aramachandran7/amp_class_d_GaN/amp/amp.pdf

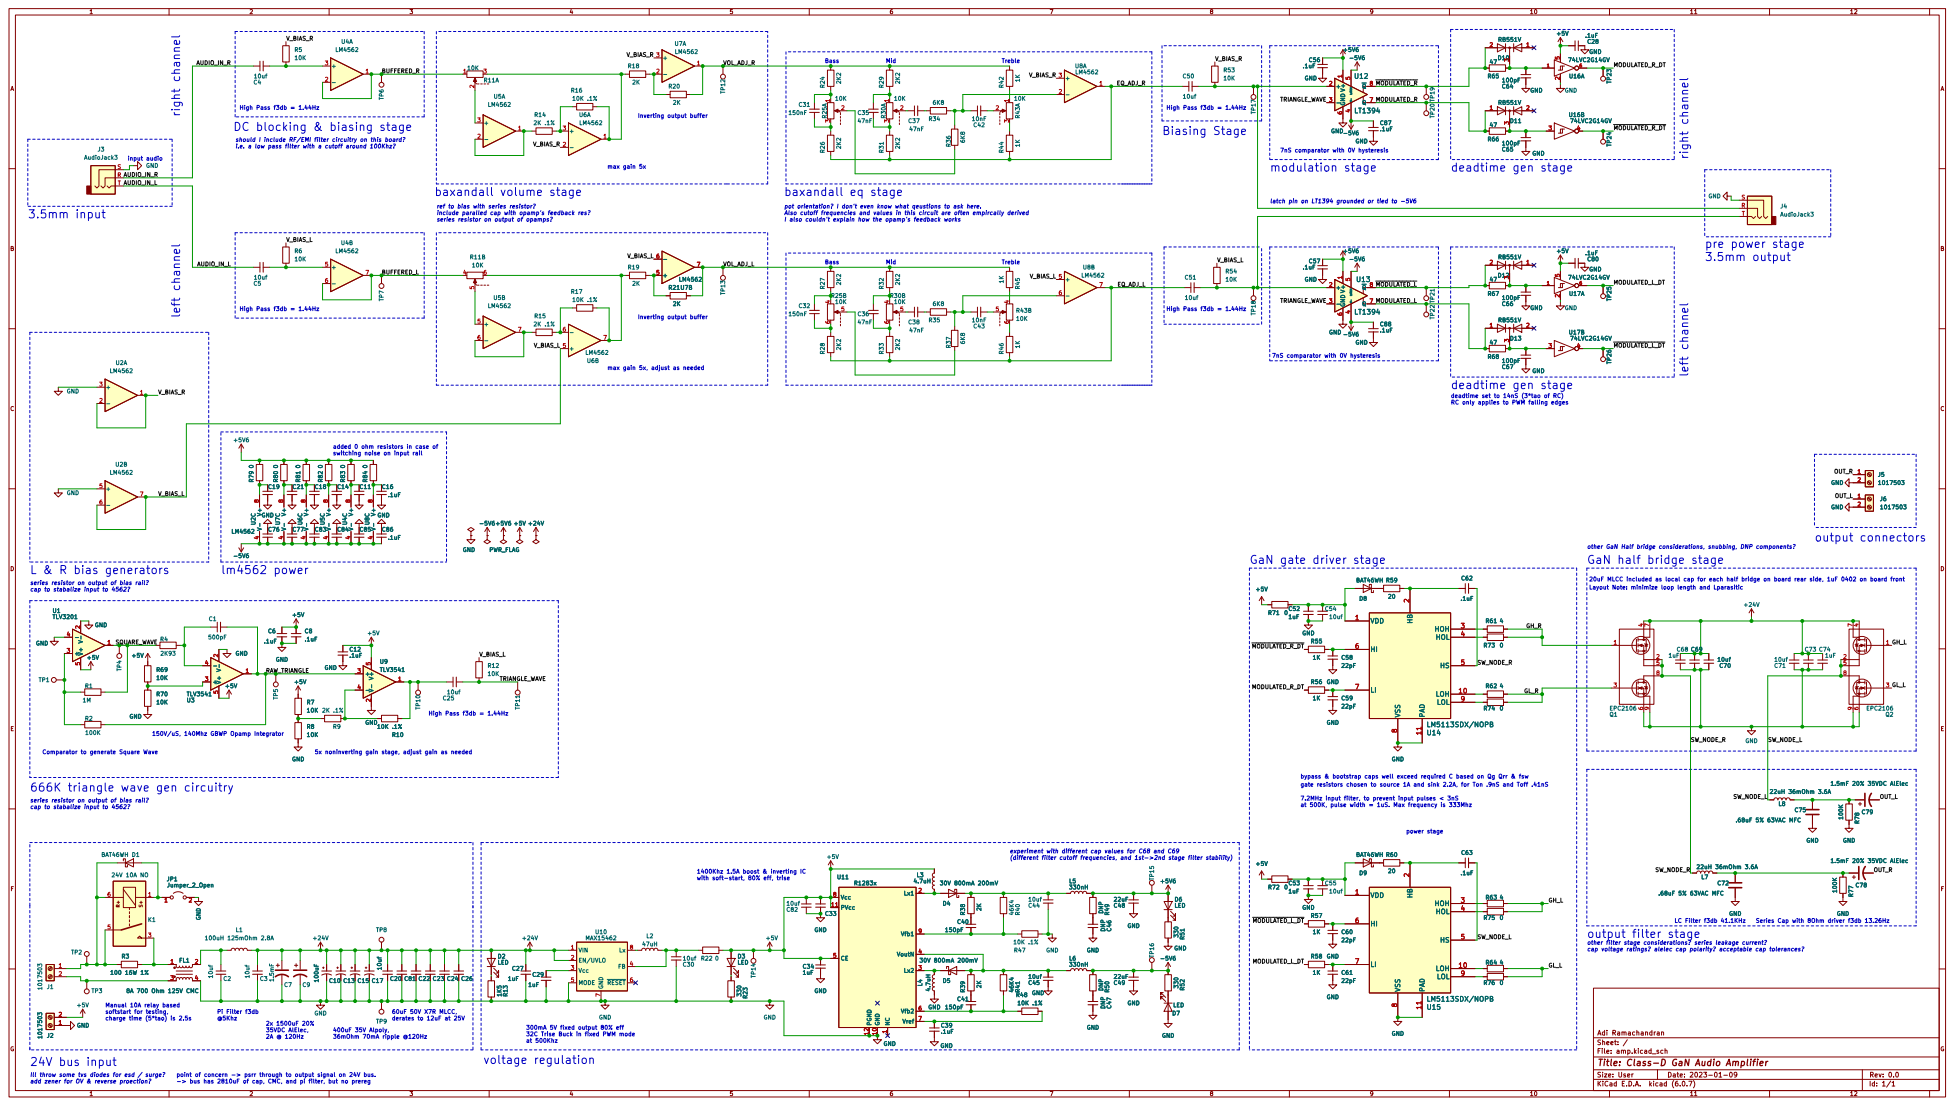
[picture p1: page 1]

DC blocking & biasing stage right channel

File: amp.kicad_sch Sheet: / Adi Ramachandran TP19 R60

should I include RF/EMI filter circuitry on this board?
i.e. a low pass filter with a cutoff around 100Khz?

ref to bias with series resistor?
include paralled cap with opamp's feedback res?
series resistor on output of opamps?

pot orientation? I don't even know what qeustions to ask here.
Also cutoff frequencies and values in this circuit are often empircally derived

latch pin on LT1394 grounded or tied to -5V6

I also couldn't explain how the opamp's feedback works added 0 ohm resistors in case of switching noise on input rail

max gain 5x, adjust as needed

deadtime set to 14nS (3*tao of RC)

other GaN Half bridge considerations, snubbing, DNP components?
GaN half bridge stage

GaN gate driver stage

20uF MLCC included as local cap for each half bridge on board rear side, 1uF 0402 on board front
Layout Note: minimize loop length and Lparasitic

series resistor on output of bias rail?
cap to stabalize input to 4562?

150V/uS, 140Mhz GBWP Opamp Integrator

power stage bypass & bootstrap caps well exceed required C based on Qg Qrr & fsw
gate resistors chosen to source 1A and sink 2.2A, for Ton .9nS and Toff .41nS

666K triangle wave gen circuitry

7.2MHz input filter, to prevent input pulses < 3nS
at 500K, pulse width = 1uS. Max frequency is 333Mhz

(different filter cutoff frequencies, and 1st->2nd stage filter stability)

1400Khz 1.5A boost & inverting IC with soft-start, 80% eff, trise

cap voltage ratings? alelec cap polarity? acceptable cap tolerances? LC Filter f3db 41.1KHz output filter stage

Series Cap with 8Ohm driver f3db 13.26Hz

other filter stage considerations? series leakage current?

Manual 10A relay based
softstart for testing,
charge time (5*tao) is 2.5s

60uF 50V X7R MLCC, derates to 12uF at 25V point of concern -> psrr through to output signal on 24V bus.

300mA 5V fixed output 80% eff 32C Trise Buck in fixed PWM mode

Id: 1/1 Title: Class-D GaN Audio Amplifier

Ill throw some tvs diodes for esd / surge?
add zener for OV & reverse proection?

-> bus has 2810uF of cap, CMC, and pi filter, but no prereg
