aramachandran7/amp_class_d_GaN/amp/amp.kicad_pcb

## KiCad design amp/amp.kicad_pcb (2023-02-12)

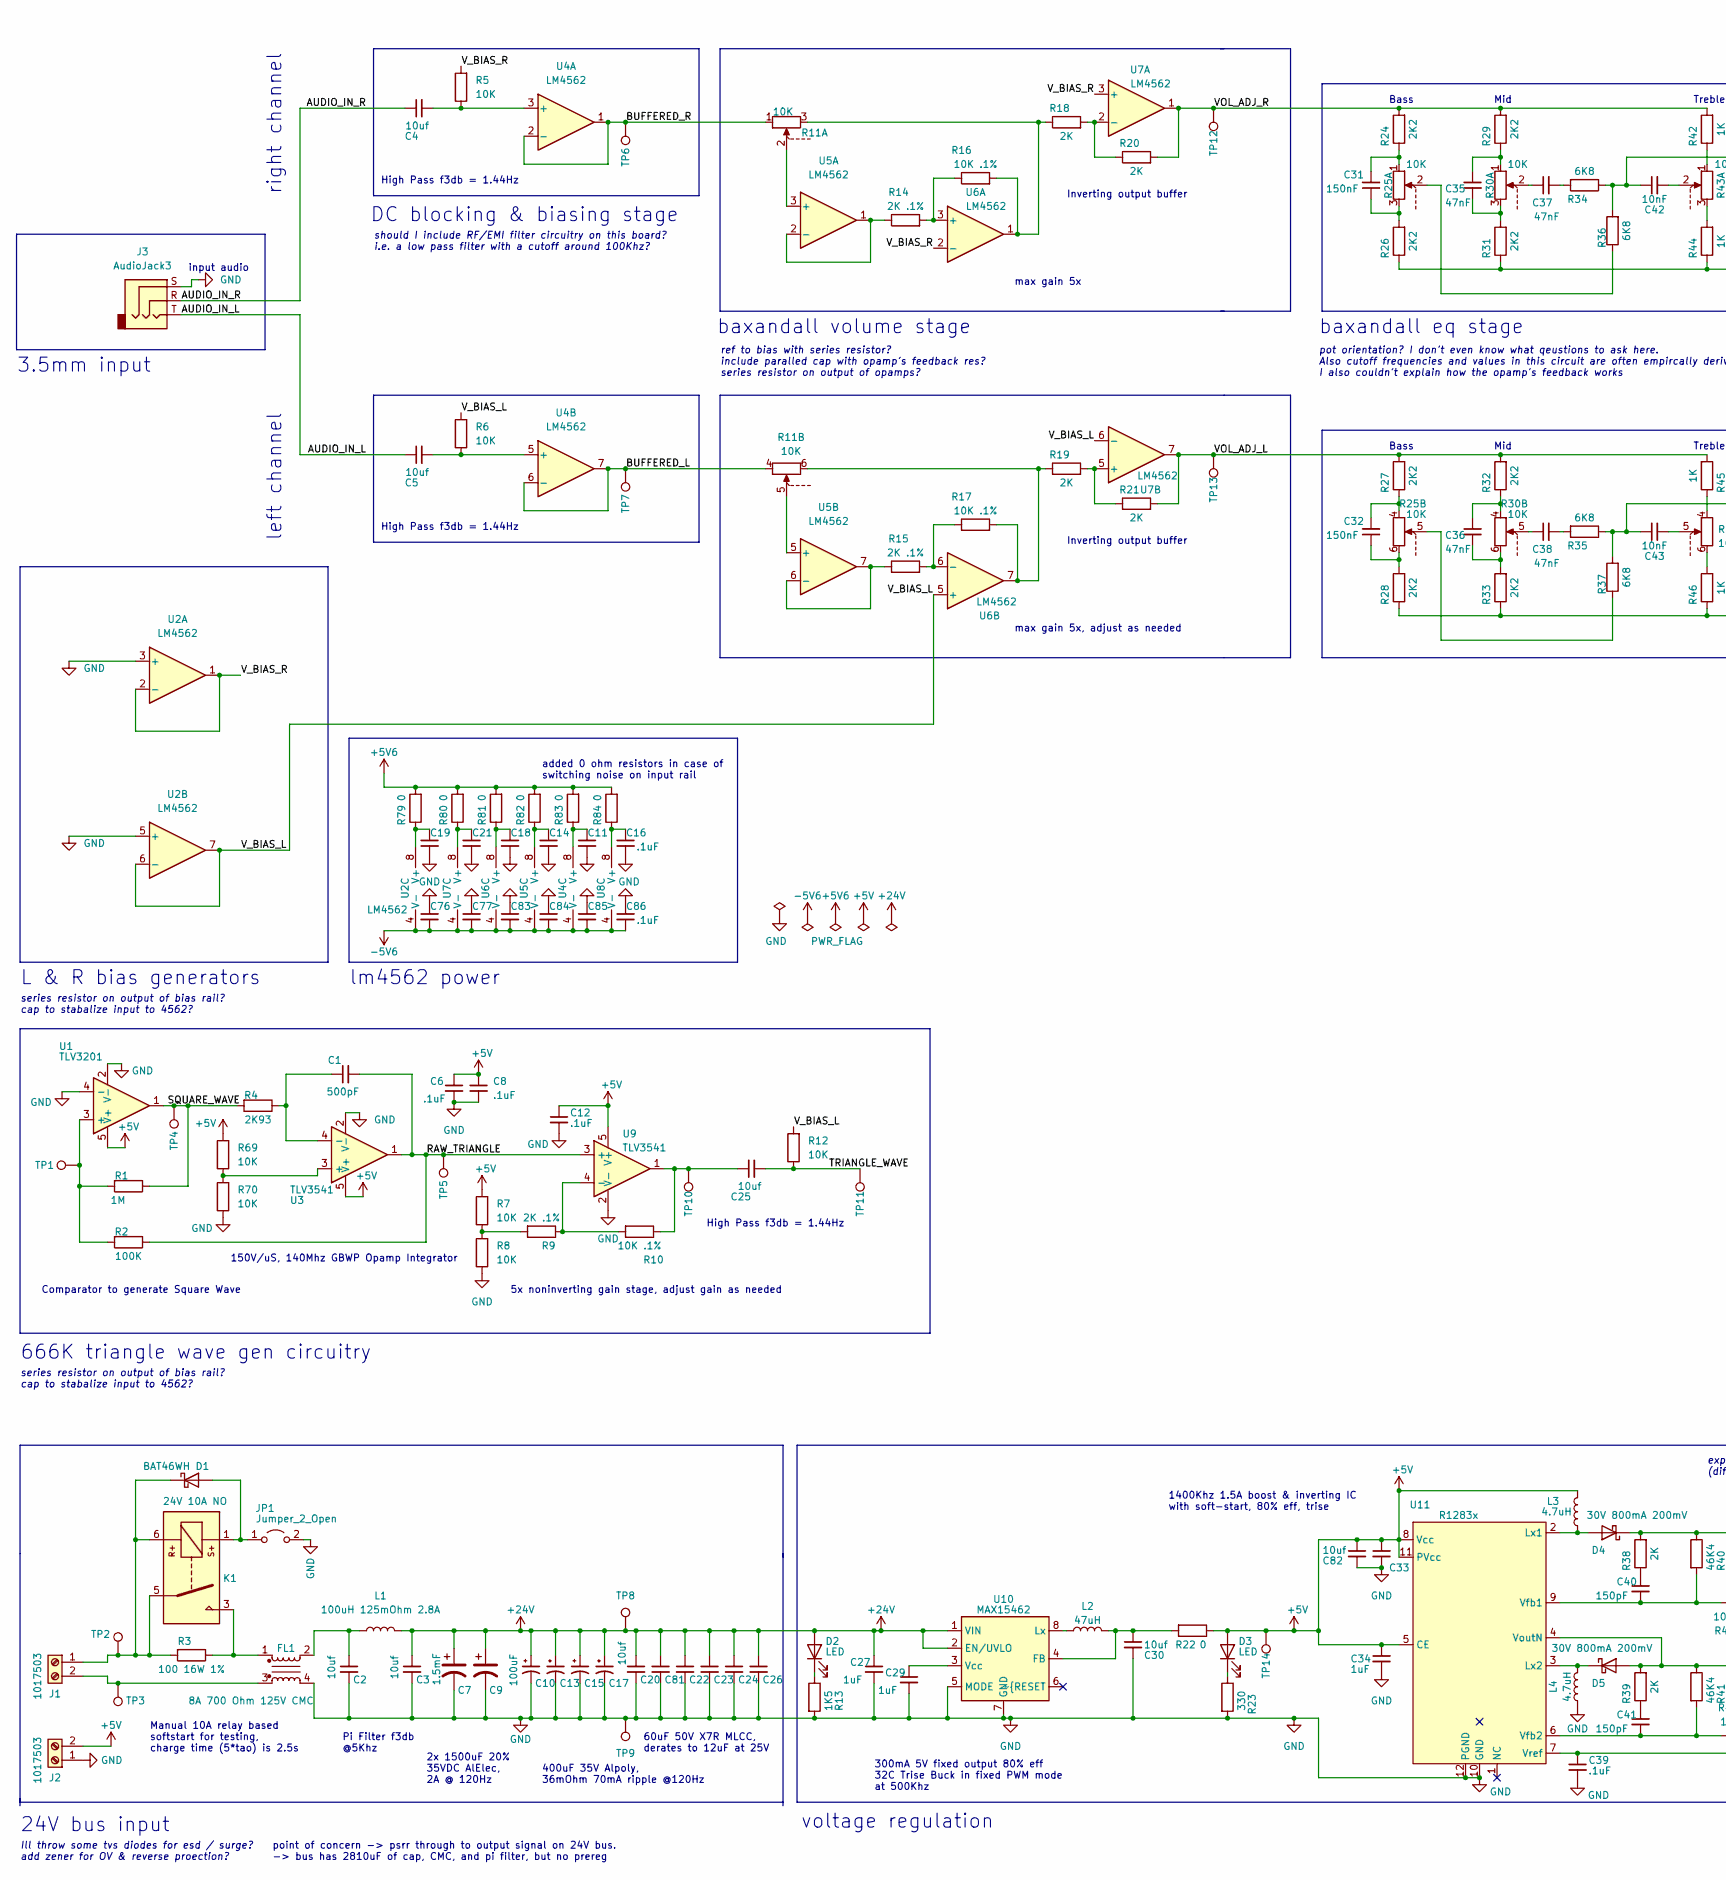
[picture p2: schematic amp.kicad_sch, Class-D GaN Audio Amplifier, part in row 1, column 1]

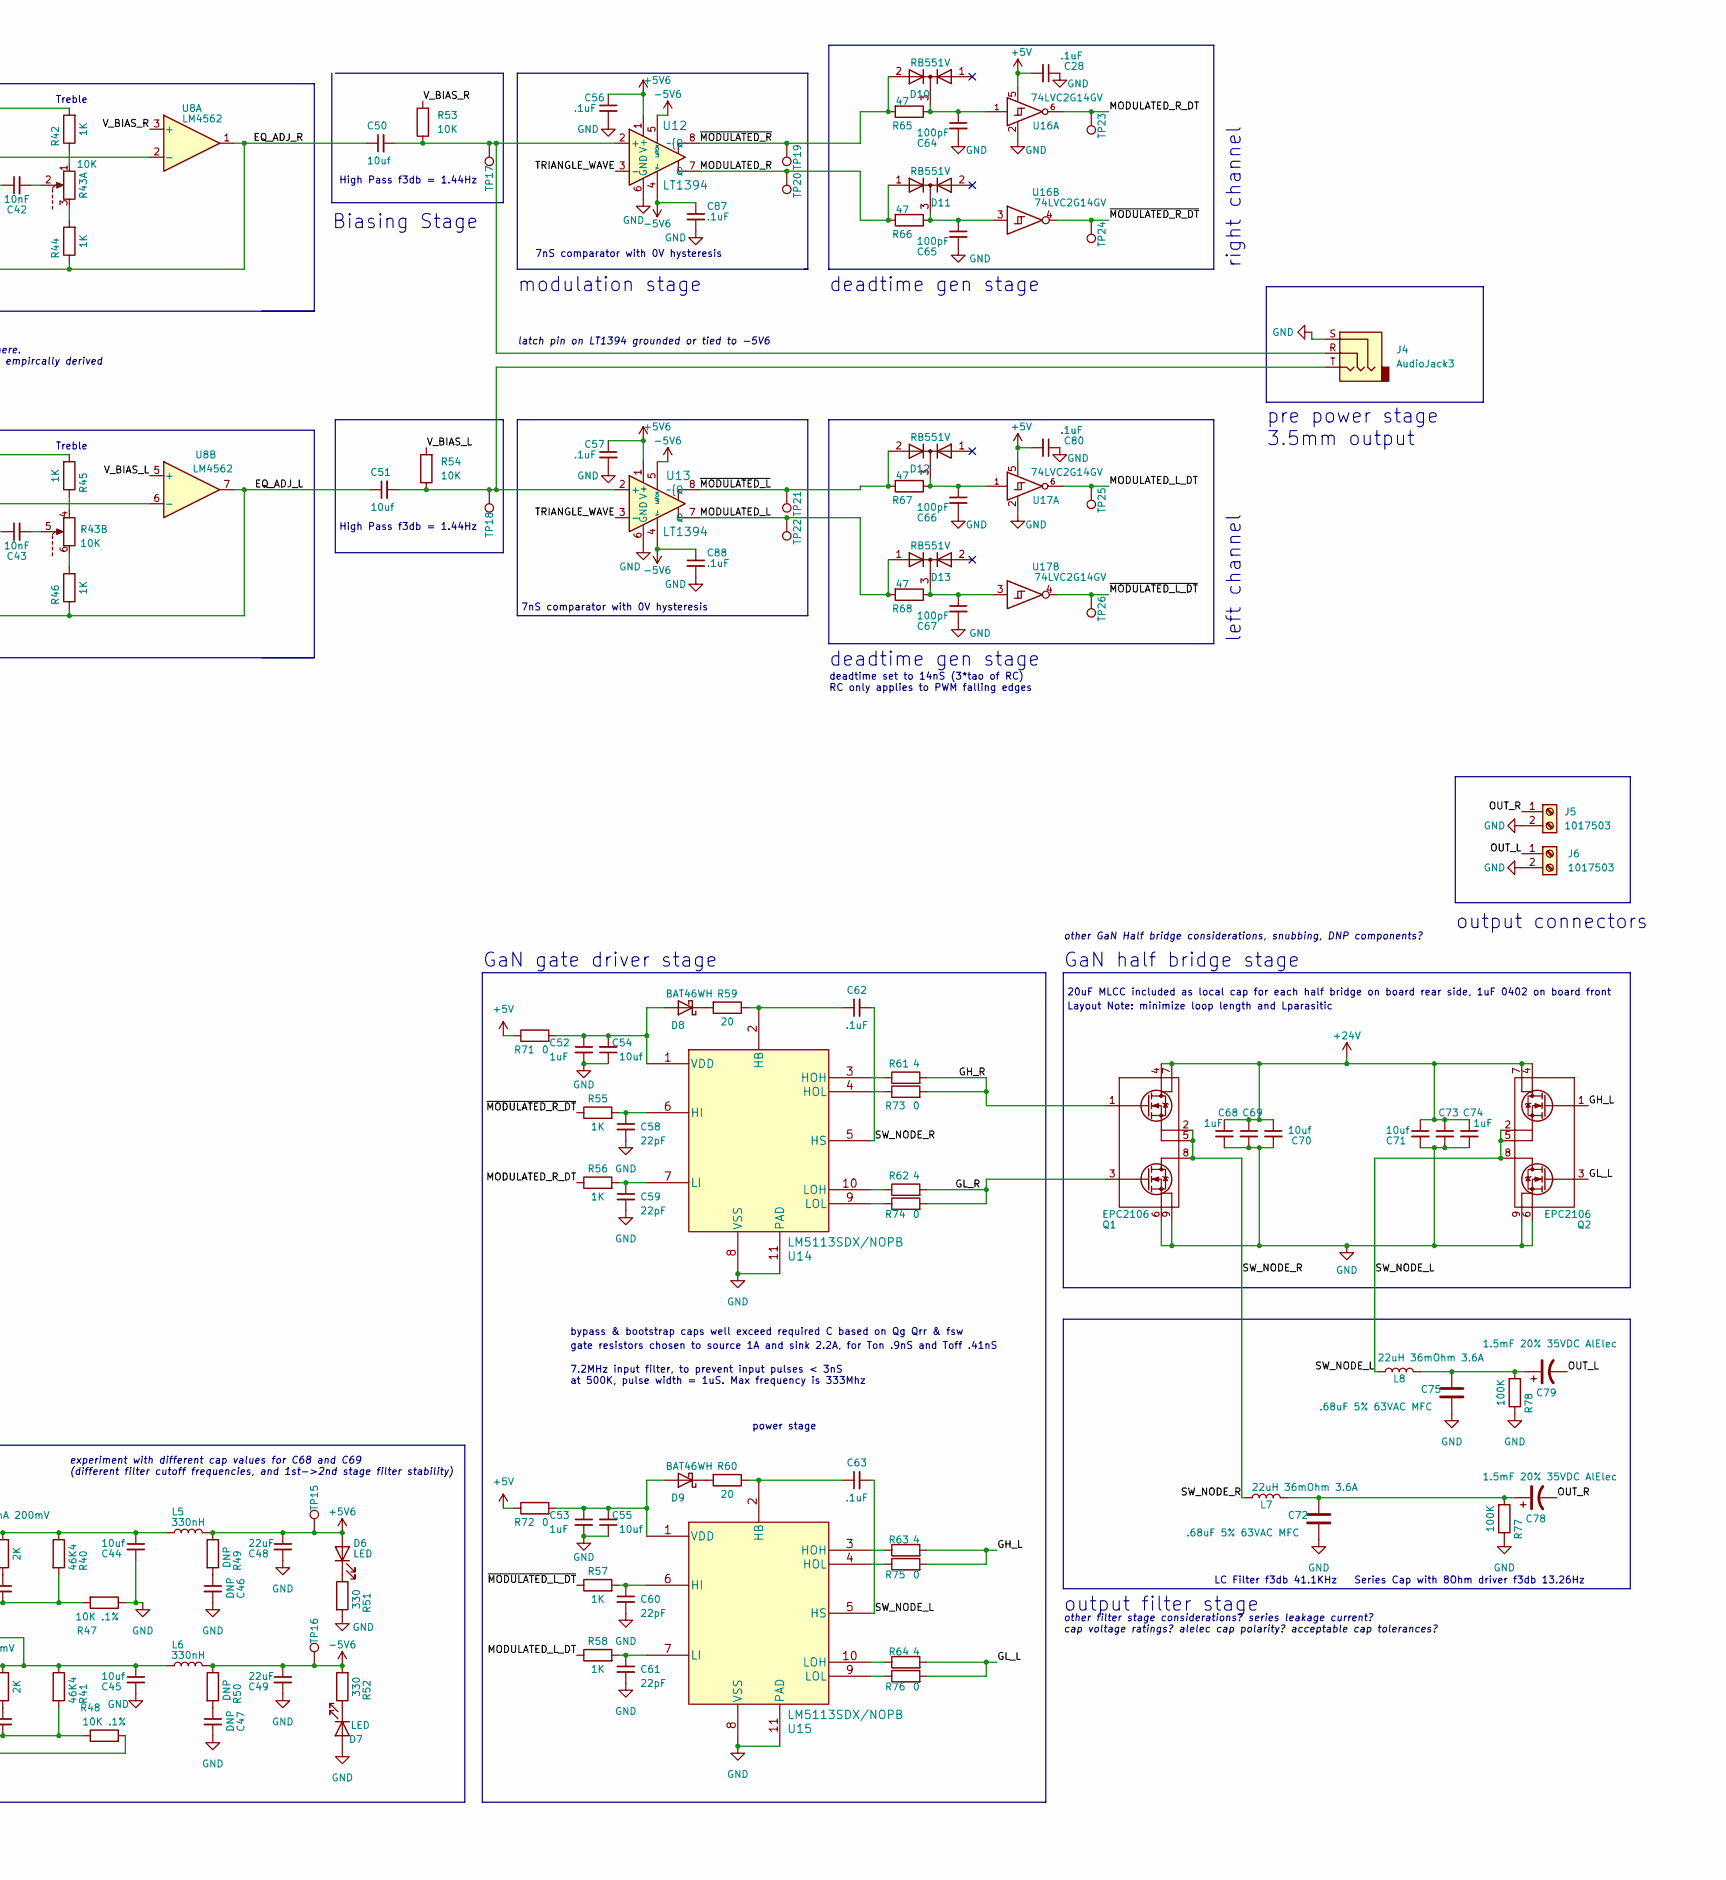
[picture p3: schematic amp.kicad_sch, Class-D GaN Audio Amplifier, part in row 1, column 2]

Parts:
C1: 500pF; C_0603_1608Metric
C2, C3, C20, C22, C23, C24, C26, C81: 10uf; C_1206_3216Metric; MPN CL31A106MBHNNNE
C4, C5, C25, C30, C33, C44, C45, C50, C51, C54, C55, C69, C70, C71, C73, C82: 10uf; C_0805_2012Metric; MPN CL31A106MBHNNNE
C6, C8, C12, C28, C39, C56, C57, C62, C63, C80, C87, C88: .1uF; C_0402_1005Metric
C7, C9: 1.5mF; CP_Radial_D12.5mm_P5.00mm; MPN 35ZLH1500MEFC12.5X30
C10, C13, C15, C17: 100uF; C_Elec_8x10.2; MPN A768EB107M1ELAE036
C11, C14, C16, C18, C19, C21, C76, C77, C83, C84, C85, C86: .1uF; C_0603_1608Metric
C27, C29, C34, C52, C53, C68, C74: 1uF; C_0402_1005Metric; MPN CL21B105KBFNNNG
C31, C32: 150nF; C_0805_2012Metric
C35, C36, C37, C38: 47nF; C_0805_2012Metric
C40, C41: 150pF; C_0603_1608Metric; MPN CC0805KRX7R9BB151
C42, C43: 10nF; C_0805_2012Metric
C46, C47: DNP; C_0805_2012Metric; MPN CL21A226MAYNNNE
C48, C49: 22uF; C_0805_2012Metric; MPN CL21A226MAYNNNE
C58, C59, C60, C61: 22pF; C_0402_1005Metric; MPN CML0805C0G220JT50V
C64, C65, C66, C67: 100pF; C_0805_2012Metric
C72, C75: .68uF 5% 63VAC MFC; C_Radial_D5.0mm_H11.0mm_P2.00mm; MPN R82EC3680AA70J
C78, C79: 1.5mF 20% 35VDC AlElec; CP_Radial_D12.5mm_P5.00mm; MPN 35ZLH1500MEFC12.5X30
D1, D8, D9: BAT46WH; D_SOD-123F
D2, D3, D6, D7: LED; LED_0805_2012Metric_Pad1.15x1.40mm_HandSolder
D4, D5: 30V 800mA 200mV; D_SOD-323; MPN CUS08F30,H3F
D10, D11, D12, D13: RB551V; SOT-23; MPN RB551V-30TC_R1_00001
FL1: 8A 700 Ohm 125V CMC; ECMS1V1306-701-R
J1, J2, J5, J6: 1017503
J3, J4: AudioJack3; SJ-3523-SMT; MPN SJ-3523-SMT-TR
JP1: Jumper_2_Open; PinHeader_1x02_P2.54mm_Vertical
K1: 24V 10A NO; AZ9375-1A-24DEF; MPN AZ9375-1A-24DEF
L1: 100uH 125mOhm 2.8A; L_12x12mm_H8mm; MPN PA4320.104NLT
L2: 47uH; L_Vishay_IHLP-1616; MPN LQH44PH470MPRL
L3, L4: 4.7uH; L_0805_2012Metric_Pad1.15x1.40mm_HandSolder; MPN WLFM201609M4R7PC
L5, L6: 330nH; EXL1V0503-R33-R; MPN EXL1V0503-R33-R
L7, L8: 22uH 36mOhm 3.6A; L_10.4x10.4_H4.8; MPN NS10165T220MNA
Q1, Q2: EPC2106; epc2106
R1: 1M; R_0603_1608Metric
R2: 100K; R_0603_1608Metric
R3: 100 16W 1%; R_2512_6332Metric
R4: 2K93; R_0603_1608Metric
R5, R6, R53, R54: 10K; R_0805_2012Metric
R7, R8, R12, R69, R70: 10K; R_0603_1608Metric
R9: 2K .1%; R_0603_1608Metric
R10, R47, R48: 10K .1%; R_0603_1608Metric
R11, R25, R30, R43: 10K; PTA4544-2010CIB103; MPN PTA4544-2010CIB103_dual
R13: 1K5; R_0805_2012Metric
R14, R15: 2K .1%; R_0805_2012Metric
R16, R17: 10K .1%; R_0805_2012Metric
R18, R19, R20, R21: 2K; R_0805_2012Metric
R22: 0; R_0805_2012Metric
R23, R51, R52: 330; R_0805_2012Metric
R24, R26, R27, R28, R29, R31, R32, R33: 2K2; R_0805_2012Metric
R34, R35, R36, R37: 6K8; R_0805_2012Metric
R38, R39: 2K; R_0603_1608Metric
R40, R41: 46K4; R_0603_1608Metric
R42, R44, R45, R46: 1K; R_0805_2012Metric
R49, R50: DNP; R_0805_2012Metric
R55, R56, R57, R58: 1K; R_0402_1005Metric
R59, R60: 20; R_0402_1005Metric
R61, R62, R63, R64: 4; R_0402_1005Metric
R65, R66, R67, R68: 47; R_0805_2012Metric
R71, R72, R73, R74, R75, R76: 0; R_0402_1005Metric
R77, R78: 100K; R_0805_2012Metric
R79, R80, R81, R82, R83, R84: 0; R_0603_1608Metric
TP1, TP4, TP5, TP10, TP11, TP12, TP13, TP17, TP18, TP19, TP20, TP21, TP22, TP23, TP24, TP25, TP26: TestPoint; TestPoint_Pad_D1.0mm
TP2, TP3, TP6, TP7, TP8, TP9, TP14, TP15, TP16: TestPoint; TestPoint_Pad_2.5x2.5mm
U1: TLV3201; SOT-23-5; MPN TLV3201AIDBVR
U2, U4, U5, U6, U7, U8: LM4562; SOIC-8_3.9x4.9mm_P1.27mm
U3, U9: TLV3541; SOT-23-5; MPN TLV3541IDBVR
U10: MAX15462; DFN-8_2x2mm_P0.5mm; MPN MAX15462BATA+T
U11: R1283x; DFN-12-1EP_3x3mm_P0.5mm_EP1.6x2.5mm; MPN R1283K002C-TR
U12, U13: LT1394; LT1394CS8-PBF; MPN LT1394CS8-PBF
U14, U15: LM5113SDX/NOPB; LM5113SDX&slash_NOPB
U16, U17: 74LVC2G14GV; SOT-363_SC-70-6; MPN 74LVC2G14GV,125

Connections:
+5V: C6.1, C8.1, C12.1, C28.2, C33.1, C34.1, C80.2, C82.1, D3.2 (A), J2.2, L3.2, R7.2, R22.1, R69.2, R71.1, R72.1, TP14.1, U1.5 (V+), U3.5 (V+), U9.5 (V+), U11.5 (CE), U11.8 (Vcc), U11.11 (PVcc), U16.5 (VCC), U17.5 (VCC)
+5V6: C48.1, C56.1, C57.1, D6.2 (A), L5.2, R49.1, R79.2, R80.2, R81.2, R82.2, R83.2, R84.2, TP15.1, U12.1 (V+), U13.1 (V+)
+24V: C3.1, C7.1, C9.1, C10.1, C13.1, C15.1, C17.1, C20.1, C22.1, C23.1, C24.1, C26.1, C27.1, C68.1, C69.1, C70.1, C71.1, C73.1, C74.1, C81.1, D2.2 (A), L1.2, Q1.4, Q1.7, Q2.4, Q2.7, TP8.1, U10.1 (VIN), U10.2 (EN/UVLO)
-5V6: C49.1, C76.2, C77.2, C83.2, C84.2, C85.2, C86.2, C87.1, C88.1, L6.2, R50.1, R52.2, TP16.1, U2.4 (V-), U4.4 (V-), U5.4 (V-), U6.4 (V-), U7.4 (V-), U8.4 (V-), U12.4 (V-), U12.5 (LATCH), U13.4 (V-), U13.5 (LATCH)
/AUDIO_IN_L: C5.1, J3.T
/AUDIO_IN_R: C4.1, J3.R
/BUFFERED_L: R11.4, TP7.1, U4.6 (-), U4.7
/BUFFERED_R: R11.1, TP6.1, U4.1, U4.2 (-)
/EQ_ADJ_L: C51.1, R28.1, R33.1, R46.1, U8.7
/EQ_ADJ_R: C50.1, R26.1, R31.1, R44.1, U8.1
/GH_L: Q2.1, R63.2, R75.2
/GH_R: Q1.1, R61.2, R73.2
/GL_L: Q2.3, R64.2, R76.2
/GL_R: Q1.3, R62.2, R74.2
/MODULATED_L: D13.1, R68.2, TP22.1, U13.7 (Q)
/MODULATED_L_DT: R58.1, TP25.1, U17.6
/MODULATED_R: D11.1, R66.2, TP20.1, U12.7 (Q)
/MODULATED_R_DT: R56.1, TP23.1, U16.6
/OUT_L: C79.2, J6.1
/OUT_R: C78.2, J5.1
/RAW_TRIANGLE: C1.2, R2.1, TP5.1, U3.1, U9.3 (+)
/SQUARE_WAVE: R1.1, R4.2, TP4.1, U1.1
/SW_NODE_L: C63.2, L8.1, Q2.2, Q2.5, Q2.8, U15.5 (HS)
/SW_NODE_R: C62.2, L7.1, Q1.2, Q1.5, Q1.8, U14.5 (HS)
/TRIANGLE_WAVE: C25.2, R12.1, TP11.1, U12.3 (-), U13.3 (-)
/VOL_ADJ_L: R21.2, R27.2, R32.2, R45.2, TP13.1, U7.7
/VOL_ADJ_R: R20.2, R24.2, R29.2, R42.2, TP12.1, U7.1
/V_BIAS_L: R6.2, R12.2, R54.2, U2.6 (-), U2.7, U6.5 (+), U7.6 (-), U8.5 (+)
/V_BIAS_R: R5.2, R53.2, U2.1, U2.2 (-), U6.2 (-), U7.3 (+), U8.3 (+)
/~MODULATED_L_DT: R57.1, TP26.1, U17.4
/~MODULATED_L: D12.2, R67.2, TP21.1, U13.8 (~{Q)
/~MODULATED_R_DT: R55.1, TP24.1, U16.4
/~MODULATED_R: D10.2, R65.2, TP19.1, U12.8 (~{Q)
GND: C2.2, C3.2, C6.2, C7.2, C8.2, C9.2, C10.2, C11.2, C12.2, C13.2, C14.2, C15.2, C16.2, C17.2, C18.2, C19.2, C20.2, C21.2, C22.2, C23.2, C24.2, C26.2, C27.2, C28.1, C29.2, C30.2, C33.2, C34.2, C39.2, C44.2, C45.2, C46.2, C47.2, C48.2, C49.2, C52.2, C53.2, C54.1, C55.1, C56.2, C57.2, C58.2, C59.2, C60.2, C61.2, C64.2, C65.2, C66.2, C67.2, C68.2, C69.2, C70.2, C71.2, C72.2, C73.2, C74.2, C75.2, C76.1, C77.1, C80.1, C81.2, C82.2, C83.1, C84.1, C85.1, C86.1, C87.2, C88.2, D7.2 (A), FL1.4, J2.1, J3.S, J4.S, J5.2, J6.2, JP1.2 (B), L4.1, Q1.6, Q1.9, Q2.6, Q2.9, R8.1, R13.2, R23.2, R47.1, R51.2, R70.1, R77.1, R78.1, TP9.1, U1.2 (V-), U1.4 (-), U2.3 (+), U2.5 (+), U3.2 (V-), U9.2 (V-), U10.5 (MODE), U10.7 (GND), U11.10 (GND), U11.12 (PGND), U11.13, U12.6 (GND), U13.6 (GND), U14.8 (VSS), U14.11 (PAD), U15.8 (VSS), U15.11 (PAD), U16.2 (GND), U17.2 (GND)
unnamed: C1.1, R4.1, U3.4 (-)
unnamed: C2.1, FL1.2, L1.1
unnamed: C4.2, R5.1, U4.3 (+)
unnamed: C5.2, R6.1, U4.5 (+)
unnamed: C11.1, R83.1, U4.8 (V+)
unnamed: C14.1, R82.1, U5.8 (V+)
unnamed: C16.1, R84.1, U8.8 (V+)
unnamed: C18.1, R81.1, U6.8 (V+)
unnamed: C19.1, R79.1, U2.8 (V+)
unnamed: C21.1, R80.1, U7.8 (V+)
unnamed: C25.1, R10.1, TP10.1, U9.1
unnamed: C29.1, U10.3 (Vcc)
unnamed: C30.1, L2.2, R22.2, U10.4 (FB)
unnamed: C31.1, R25.3, R26.2
unnamed: C31.2, R24.1, R25.1
unnamed: C32.1, R25.6, R28.2
unnamed: C32.2, R25.4, R27.1
unnamed: C35.1, R29.1, R30.1
unnamed: C35.2, R30.3, R31.2
unnamed: C36.1, R30.4, R32.1
unnamed: C36.2, R30.6, R33.2
unnamed: C37.1, R30.2
unnamed: C37.2, R34.2
unnamed: C38.1, R30.5
unnamed: C38.2, R35.2
unnamed: C39.1, R48.2, U11.7 (Vref)
unnamed: C40.1, R38.1
unnamed: C40.2, R40.2, R47.2, U11.9 (Vfb1)
unnamed: C41.1, R39.1
unnamed: C41.2, R41.2, R48.1, U11.6 (Vfb2)
unnamed: C42.1, R34.1, R36.2, U8.2 (-)
unnamed: C42.2, R43.2
unnamed: C43.1, R35.1, R37.2, U8.6 (-)
unnamed: C43.2, R43.5
unnamed: C44.1, D4.1 (K), L5.1, R38.2, R40.1
unnamed: C45.1, D5.2 (A), L6.1, R39.2, R41.1, U11.4 (VoutN)
unnamed: C46.1, R49.2
unnamed: C47.1, R50.2
unnamed: C50.2, J4.R, R53.1, TP17.1, U12.2 (+)
unnamed: C51.2, J4.T, R54.1, TP18.1, U13.2 (+)
unnamed: C52.1, C54.2, D8.2 (A), R71.2, U14.1 (VDD)
unnamed: C53.1, C55.2, D9.2 (A), R72.2, U15.1 (VDD)
unnamed: C58.1, R55.2, U14.6 (HI)
unnamed: C59.1, R56.2, U14.7 (LI)
unnamed: C60.1, R57.2, U15.6 (HI)
unnamed: C61.1, R58.2, U15.7 (LI)
unnamed: C62.1, R59.1, U14.2 (HB)
unnamed: C63.1, R60.1, U15.2 (HB)
unnamed: C64.1, D10.3, R65.1, U16.1
unnamed: C65.1, D11.3, R66.1, U16.3
unnamed: C66.1, D12.3, R67.1, U17.1
unnamed: C67.1, D13.3, R68.1, U17.3
unnamed: C72.1, C78.1, L7.2, R77.2
unnamed: C75.1, C79.1, L8.2, R78.2
unnamed: D1.1 (K), J1.1, K1.5, K1.6, R3.2, TP2.1
unnamed: D1.2 (A), JP1.1 (A), K1.1
unnamed: D2.1 (K), R13.1
unnamed: D3.1 (K), R23.1
unnamed: D4.2 (A), L3.1, U11.2 (Lx1)
unnamed: D5.1 (K), L4.2, U11.3 (Lx2)
unnamed: D6.1 (K), R51.1
unnamed: D7.1 (K), R52.1
unnamed: D8.1 (K), R59.2
unnamed: D9.1 (K), R60.2
unnamed: FL1.1, K1.3, R3.1
unnamed: FL1.3, J1.2, TP3.1
unnamed: L2.1, U10.8 (Lx)
unnamed: R1.2, R2.2, TP1.1, U1.3 (+)
unnamed: R7.1, R8.2, R9.2
unnamed: R9.1, R10.2, U9.4 (-)
unnamed: R11.2, U5.3 (+)
unnamed: R11.3, R16.2, R18.1, U6.1
unnamed: R11.5, U5.5 (+)
unnamed: R11.6, R17.2, R19.1, U6.7
unnamed: R14.1, U5.1, U5.2 (-)
unnamed: R14.2, R16.1, U6.3 (+)
unnamed: R15.1, U5.6 (-), U5.7
unnamed: R15.2, R17.1, U6.6 (-)
unnamed: R18.2, R20.1, U7.2 (-)
unnamed: R19.2, R21.1, U7.5 (+)
unnamed: R25.2, R36.1
unnamed: R25.5, R37.1
unnamed: R42.1, R43.1
unnamed: R43.3, R44.2
unnamed: R43.4, R45.1
unnamed: R43.6, R46.2
unnamed: R61.1, U14.3 (HOH)
unnamed: R62.1, U14.10 (LOH)
unnamed: R63.1, U15.3 (HOH)
unnamed: R64.1, U15.10 (LOH)
unnamed: R69.1, R70.2, U3.3 (+)
unnamed: R73.1, U14.4 (HOL)
unnamed: R74.1, U14.9 (LOL)
unnamed: R75.1, U15.4 (HOL)
unnamed: R76.1, U15.9 (LOL)

Notes on the sheet:
Comparator to generate Square Wave
pot orientation? I don't even know what qeustions to ask here. Also cutoff frequencies and values in this circuit are often empircally derived I also couldn't explain how the opamp's feedback works
left channel
max gain 5x
Treble
deadtime gen stage
High Pass f3db = 1.44Hz
voltage regulation
150V/uS, 140Mhz GBWP Opamp Integrator
Ill throw some tvs diodes for esd / surge? add zener for OV & reverse proection?
modulation stage
baxandall volume stage
666K triangle wave gen circuitry
right channel
2x 1500uF 20% 35VDC AlElec, 2A @ 120Hz
Pi Filter f3db @5Khz
latch pin on LT1394 grounded or tied to -5V6
series resistor on output of bias rail? cap to stabalize input to 4562?
power stage
3.5mm input
5x noninverting gain stage, adjust gain as needed
other filter stage considerations? series leakage current? cap voltage ratings? alelec cap polarity? acceptable cap tolerances?
max gain 5x, adjust as needed
L & R bias generators
60uF 50V X7R MLCC, derates to 12uF at 25V
24V bus input
ref to bias with series resistor? include paralled cap with opamp's feedback res? series resistor on output of opamps?
deadtime set to 14nS (3*tao of RC) RC only applies to PWM falling edges
LC Filter f3db 41.1KHz
Inverting output buffer
Bass
7nS comparator with 0V hysteresis
GaN half bridge stage
gate resistors chosen to source 1A and sink 2.2A, for Ton .9nS and Toff .41nS
Layout Note: minimize loop length and Lparasitic
point of concern -> psrr through to output signal on 24V bus. -> bus has 2810uF of cap, CMC, and pi filter, but no prereg
Series Cap with 8Ohm driver f3db 13.26Hz
output connectors
300mA 5V fixed output 80% eff 32C Trise Buck in fixed PWM mode at 500Khz
experiment with different cap values for C68 and C69 (different filter cutoff frequencies, and 1st->2nd stage filter stability)
other GaN Half bridge considerations, snubbing, DNP components?
bypass & bootstrap caps well exceed required C based on Qg Qrr & fsw
20uF MLCC included as local cap for each half bridge on board rear side, 1uF 0402 on board front
Biasing Stage
output filter stage
400uF 35V Alpoly, 36mOhm 70mA ripple @120Hz
GaN gate driver stage
7.2MHz input filter, to prevent input pulses < 3nS at 500K, pulse width = 1uS. Max frequency is 333Mhz
Mid
input audio
should I include RF/EMI filter circuitry on this board? i.e. a low pass filter with a cutoff around 100Khz?
Manual 10A relay based softstart for testing, charge time (5*tao) is 2.5s
baxandall eq stage
DC blocking & biasing stage
pre power stage 3.5mm output
added 0 ohm resistors in case of switching noise on input rail
1400Khz 1.5A boost & inverting IC with soft-start, 80% eff, trise
lm4562 power

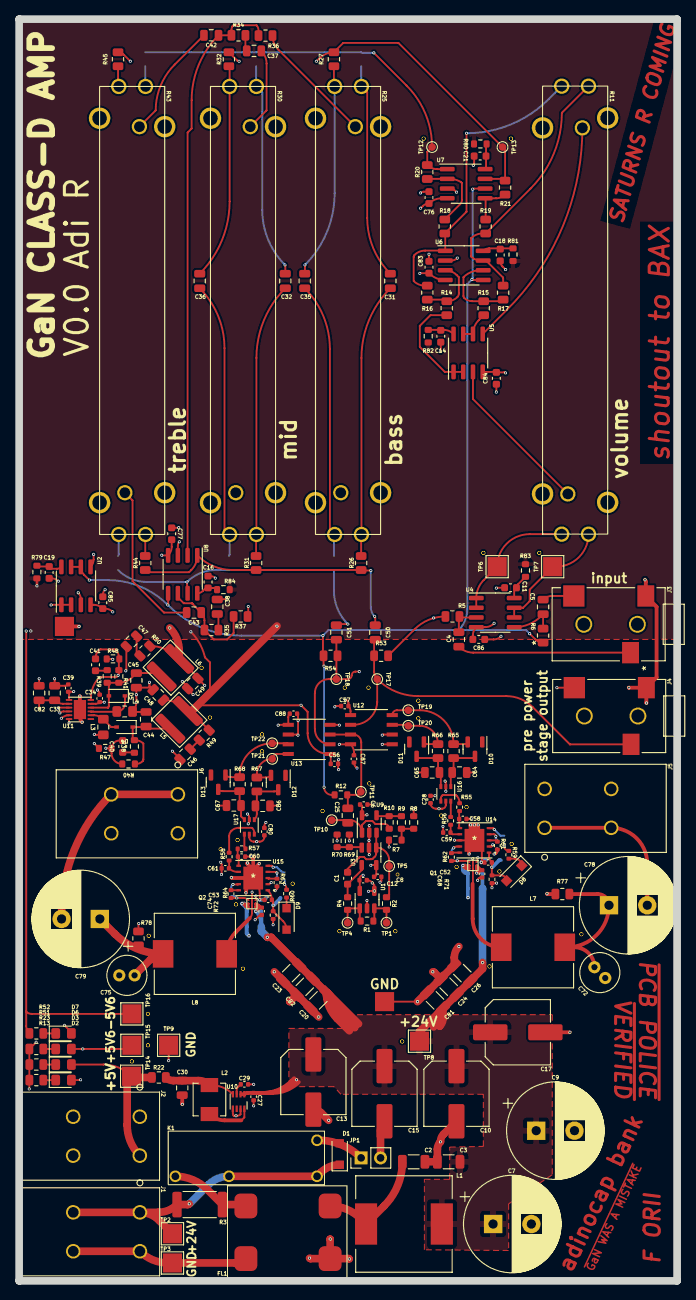
[picture p4: board amp.kicad_pcb from above]

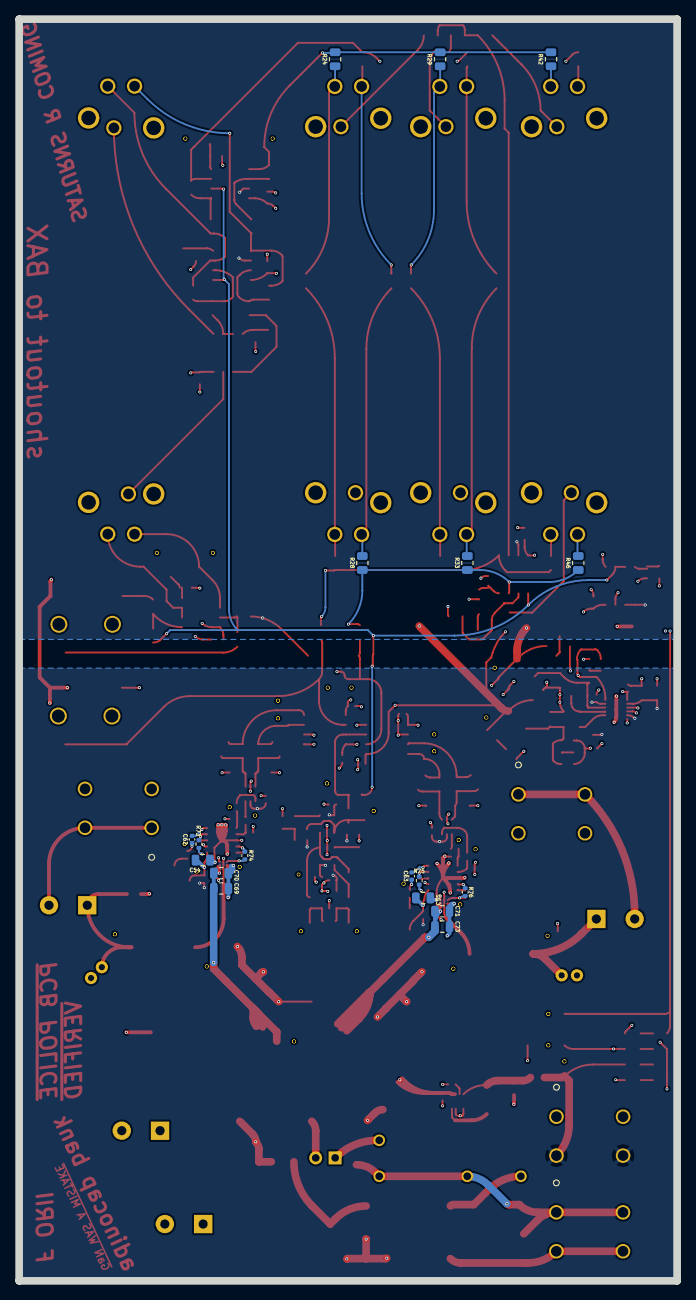
[picture p5: board amp.kicad_pcb from below]

Board: 4 copper layers, 85.9 x 164.8 mm, 243 parts (18 on the bottom side), 129 nets.
