aramachandran7/amp_class_d_GaN/(commit log)

2022-11-10 schem first pass
    [amp.kicad_pcb, amp.kicad_sch]
2023-01-18 lots of schem and layouts updates
    [amp.kicad_pcb, amp.kicad_sch]
2023-02-12 shipped rev0 hardware
    [amp-B_Cu.gbr, amp-B_Mask.gbr, amp-B_Silkscreen.gbr, amp-Edge_Cuts.gbr, amp-F_Cu.gbr, amp-F_Mask.gbr, amp-F_Silkscreen.gbr, amp-In1_Cu.gbr]
